PelionIoT/reference-design-RD1622/README.md

# RD1622 Introduction:

The RD1622 Reference Design is a Pelion Ready design based on the hostless Advantech WISE-1530 Wi-Fi module which includes an ST Microcontroller (STM32F412) and a Cypress Wi-Fi device (CYW43438).

The reference design is a tested and proven starting point targetted towards the creation of both Development Boards and End Products.

# Reference Design Contents:
**Reference Schematic**
This is the core of reference design, and illustrates where and how the essential components are connected.

**Reference Application**
Built on mbedOS, and includes Pelion Device Manager. This application has been configured to run on the Reference Design hardware, and will connect to the Pelion Cloud, and is capable of running the cloud based update service.

**Example Implementation**
Based on the Reference Design, this example implementation is included to demonstrate the Reference Design being used to create real-world hardware. The example implemenation is used within Arm to include the Reference Design into the internal test infrastructure, it is comprised of two parts:

*MCB (Module Carrier Board)* - this was created based on the Reference Design schematic

*MTB (Module Test Bed)* - this is part of the test infrastructure, and includes DAPLink circuit for programming the device, a range of I/O and loopback paths for automated testing.

# Version Information:

| Release | mbed OS | mbed Cloud Client | Release Date | Comment |
| --- | --- | --- | --- | --- |
|v1.0 | 5.9.5	| 1.3.3	| 20/09/2018 | Initial Release
| |  |  | |

Back to [Reference Designs](https://github.com/ARMmbed/reference-designs)
