PelionIoT/reference-design-RD1622/Hardware/Example_Implementation/Module_Carrier_Board/MCB-Wise-1530-v2.0.1-BOM.xlsx

Qty | Value | Device | Package | Parts | Description | MF | MFN | OC-DIGIKEY | OC-MOUSER | OC-NEWARK
5 | 100nF | C0603 | 0603 | C1, C2, C3, C6, C7 | Capacitor |  |  | 732-7989-1-ND | 710-885012206071 | 2392304
3 | 10k | R0603 | 0603 | R1, R2, R3 | Resistor |  |  | 311-10KGRCT-ND | 603-RC0603JR-0710KL | 2447230
1 | 1k | R0603 | 0603 | R8 | Resistor |  |  | 311-1.0KGRCT-ND | 603-RC0603JR-071KL | 2447272
1 | 3030 | 3030 | 3030 | BAT1 | CR927, CR1025 Battery Holder for 9-10mm Cells-Tin Nickel Plated SMD | Keystone | 3030 | 36-3030-ND | 534-3030 | 39T8899
1 | ATECC608A | ATECC608A | SO8 | IC1 | I2C Secure element and crytpo accelerator | Atmel | ATECC608A | ATECC608A-SSHDA-TCT-ND | 556-ATECC608ASSHDAB
1 | MX25R3235FM1IH0 | MX25R3235FM1IH0 | SO8 | IC2 | Serial Flash 32 Mb 80 Mhz | Macronix | MX25R3235FM1IH0 | 1092-1175-ND
1 | RED | SMD_LED0603 | CHIPLED_0603 | LED1 | LED SMD, Colour Red | Wurth Electronics Inc | 150060RS75000 | 732-4978-1-ND | 710-150060RS75000 | 2322071
1 | TE-1-1734592-0 | TE-1-1734592-0 | TE-1-1734592-0 | CON3 | 10 way FPC cable connector | TE Connectivity | TE-1-1734592-0 | A100282CT-ND | 571-1-1734592-0
1 | WISE-1530 | WISE-1530 | MDT420E02001 | MOD1 | Connector for Advantex WISE-1530 module | Amphenol | MDT420E02001 | na | 523-MDT420E02001 | na
