PelionIoT/reference-design-RD1622/Hardware/Reference_Schematic/Advantech-Wise-1530-v1.0.0-SCH.pdf

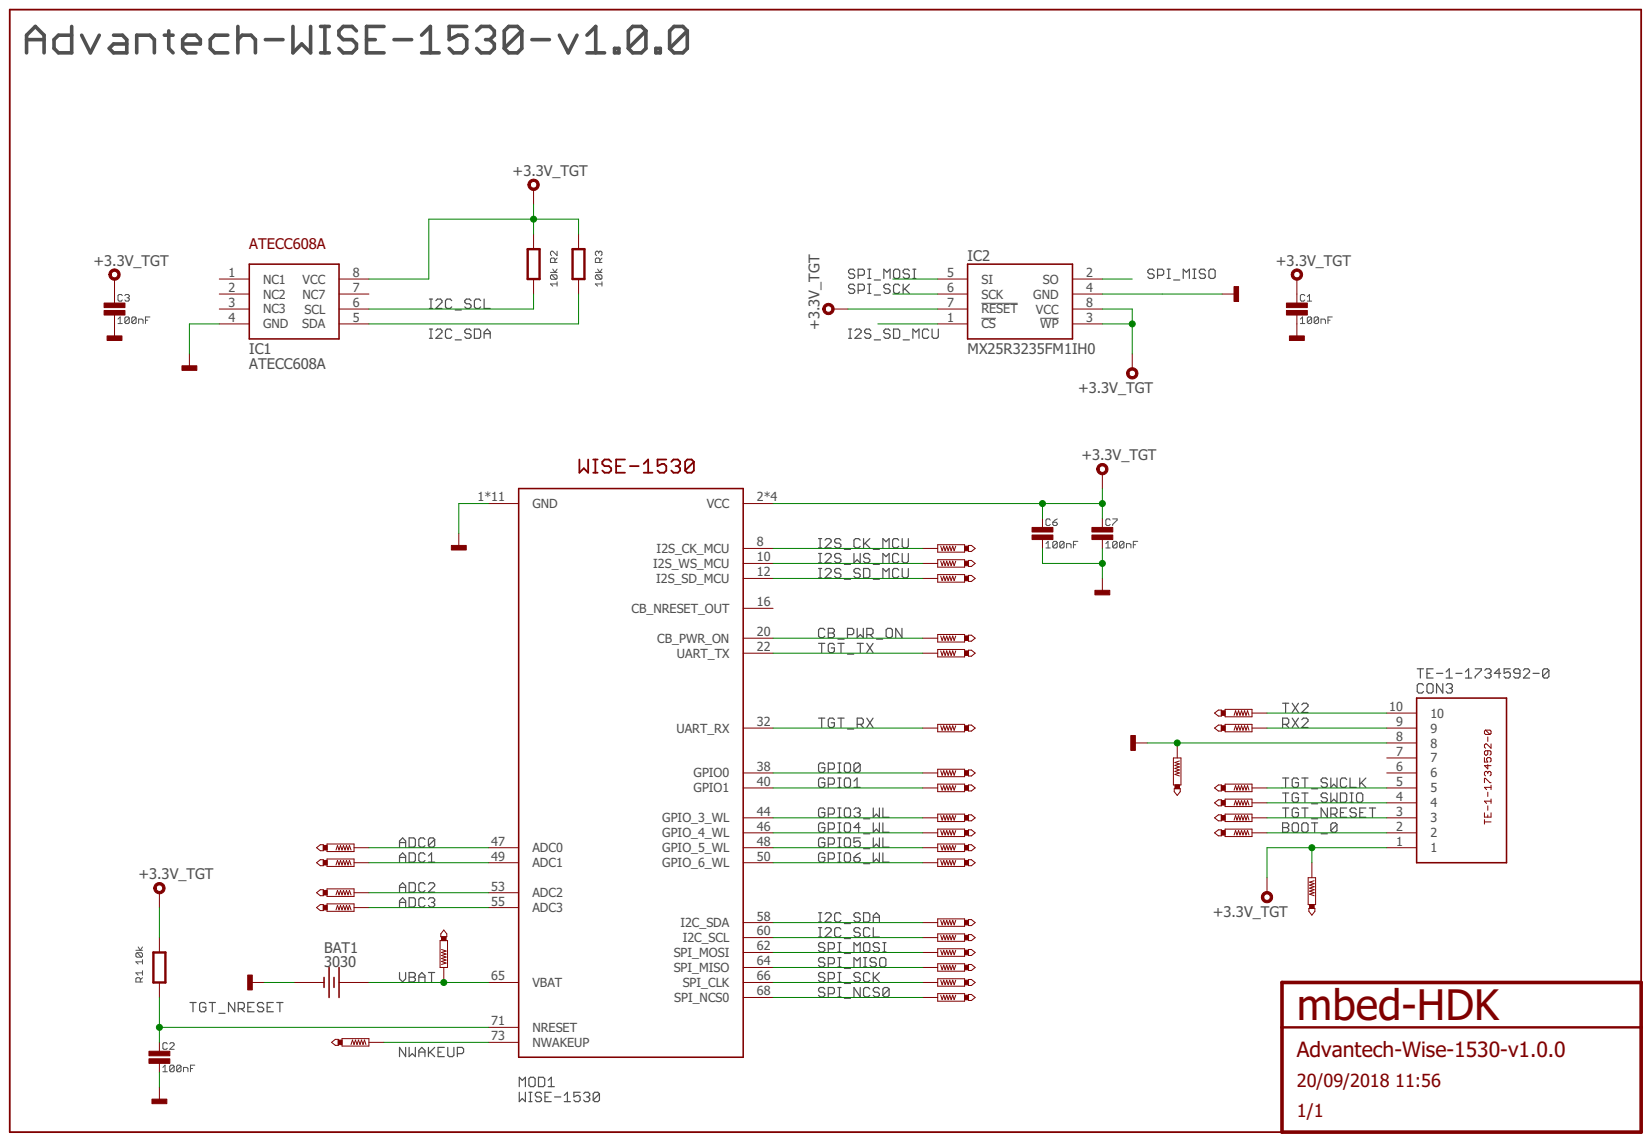
[picture p1: page 1]
