PelionIoT/reference-design-RD1622/Hardware/Example_Implementation/Module_Test_Bed/MTB-v2.0.0.brd

## EAGLE design Hardware/Example_Implementation/Module_Test_Bed/MTB-v2.0.0.brd (2018-09-20)

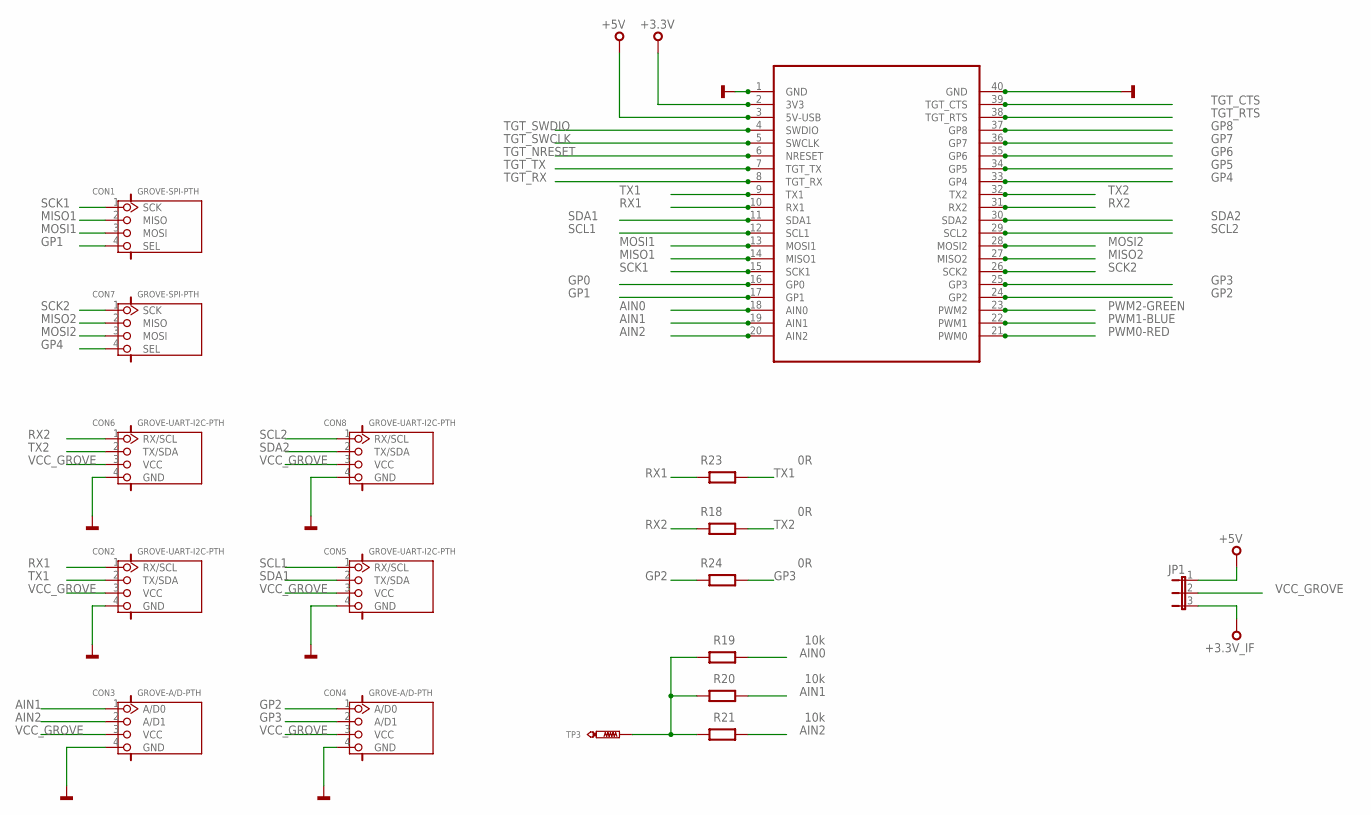
[picture p2: schematic MTB-v2.0.0.sch, sheet 1]

Parts:
CON1, CON7: GROVE-SPI-PTH; HW4-2.0
CON2, CON5, CON6, CON8: GROVE-UART-I2C-PTH; HW4-2.0
CON3, CON4: GROVE-A/D-PTH; HW4-2.0
JP1: JP2E; JP2
R18, R23, R24: 0R; 0603@1
R19, R20, R21: 10k; 0603@1
SKT1: MODULE_SOCKET
TP3: TEST-POINT-50R-PTH; TP50-PTH

Connections:
+3.3V: SKT1.2 (3V3), SKT1.P$42; also elsewhere on the board
+3.3V_IF: JP1.3; also elsewhere on the board
+5V: JP1.1, SKT1.3 (5V-USB), SKT1.P$43; also elsewhere on the board
AIN0: R19.1, SKT1.18 (AIN0), SKT1.P$58; also elsewhere on the board
AIN1: CON3.1 (A/D0), R20.1, SKT1.19 (AIN1), SKT1.P$59
AIN2: CON3.2 (A/D1), R21.1, SKT1.20 (AIN2), SKT1.P$60
GND: CON2.4 (GND), CON3.4 (GND), CON4.4 (GND), CON5.4 (GND), CON6.4 (GND), CON8.4 (GND), SKT1.1 (GND), SKT1.40 (GND), SKT1.P$41, SKT1.P$80; also elsewhere on the board
GP0: SKT1.16 (GP0), SKT1.P$56; also elsewhere on the board
GP1: CON1.4 (SEL), SKT1.17 (GP1), SKT1.P$57
GP2: CON4.1 (A/D0), R24.2, SKT1.24 (GP2), SKT1.P$64; also elsewhere on the board
GP3: CON4.2 (A/D1), R24.1, SKT1.25 (GP3), SKT1.P$65
GP4: CON7.4 (SEL), SKT1.33 (GP4), SKT1.P$73
GP5: SKT1.34 (GP5), SKT1.P$74; also elsewhere on the board
GP6: SKT1.35 (GP6), SKT1.P$75; also elsewhere on the board
GP7: SKT1.36 (GP7), SKT1.P$76; also elsewhere on the board
GP8: SKT1.37 (GP8), SKT1.P$77
MISO1: CON1.2 (MISO), SKT1.14 (MISO1), SKT1.P$54; also elsewhere on the board
MISO2: CON7.2 (MISO), SKT1.27 (MISO2), SKT1.P$67
MOSI1: CON1.3 (MOSI), SKT1.13 (MOSI1), SKT1.P$53; also elsewhere on the board
MOSI2: CON7.3 (MOSI), SKT1.28 (MOSI2), SKT1.P$68
unnamed: R19.2, R20.2, R21.2, TP3.TP
PWM0-RED: SKT1.21 (PWM0), SKT1.P$61; also elsewhere on the board
PWM1-BLUE: SKT1.22 (PWM1), SKT1.P$62; also elsewhere on the board
PWM2-GREEN: SKT1.23 (PWM2), SKT1.P$63; also elsewhere on the board
RX1: CON2.1 (RX/SCL), R23.2, SKT1.10 (RX1), SKT1.P$50
RX2: CON6.1 (RX/SCL), R18.2, SKT1.31 (RX2), SKT1.P$71
SCK1: CON1.1 (SCK), SKT1.15 (SCK1), SKT1.P$55; also elsewhere on the board
SCK2: CON7.1 (SCK), SKT1.26 (SCK2), SKT1.P$66
SCL1: CON5.1 (RX/SCL), SKT1.12 (SCL1), SKT1.P$52; also elsewhere on the board
SCL2: CON8.1 (RX/SCL), SKT1.29 (SCL2), SKT1.P$69; also elsewhere on the board
SDA1: CON5.2 (TX/SDA), SKT1.11 (SDA1), SKT1.P$51; also elsewhere on the board
SDA2: CON8.2 (TX/SDA), SKT1.30 (SDA2), SKT1.P$70; also elsewhere on the board
TGT_CTS: SKT1.39 (TGT_CTS), SKT1.P$79; also elsewhere on the board
TGT_NRESET: SKT1.6 (NRESET), SKT1.P$46; also elsewhere on the board
TGT_RTS: SKT1.38 (TGT_RTS), SKT1.P$78; also elsewhere on the board
TGT_RX: SKT1.8 (TGT_RX), SKT1.P$48; also elsewhere on the board
TGT_SWCLK: SKT1.5 (SWCLK), SKT1.P$45; also elsewhere on the board
TGT_SWDIO: SKT1.4 (SWDIO), SKT1.P$44; also elsewhere on the board
TGT_TX: SKT1.7 (TGT_TX), SKT1.P$47; also elsewhere on the board
TX1: CON2.2 (TX/SDA), R23.1, SKT1.9 (TX1), SKT1.P$49
TX2: CON6.2 (TX/SDA), R18.1, SKT1.32 (TX2), SKT1.P$72
VCC_GROVE: CON2.3 (VCC), CON3.3 (VCC), CON4.3 (VCC), CON5.3 (VCC), CON6.3 (VCC), CON8.3 (VCC), JP1.2

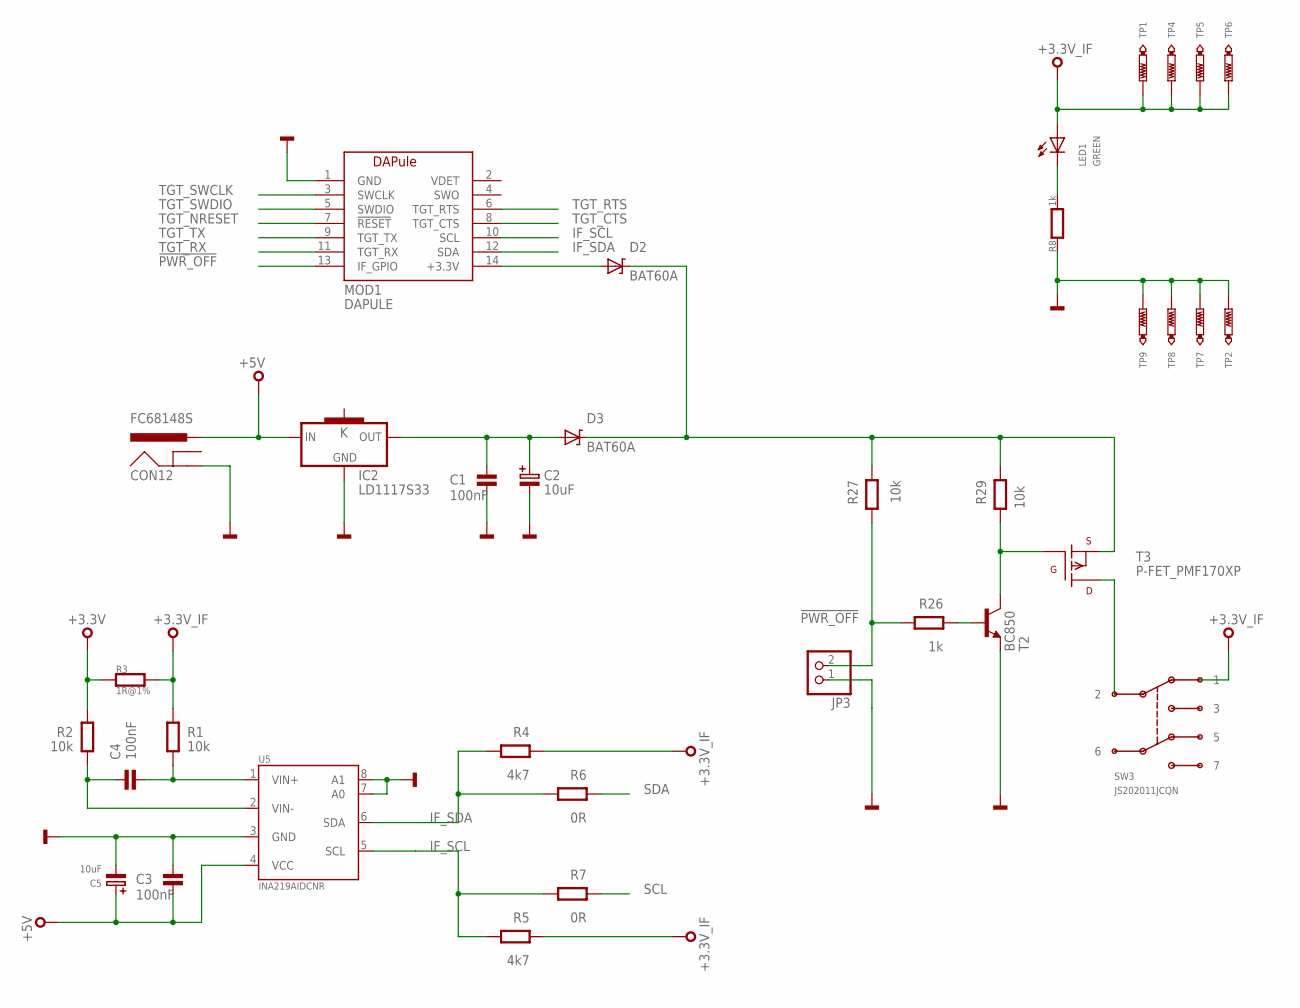
[picture p3: schematic MTB-v2.0.0.sch, sheet 2]

Parts:
C1, C3, C4: 100nF; 0603
C2: 10uF; SMC_B
C5: 10uF; SMC_A
CON12: FC68148S
D2, D3: BAT60A; SOD323
IC2: LD1117S33; SOT223
JP3: PINHD-1X2; 1X02
LED1: GREEN; CHIPLED_0603
MOD1: DAPULE
R1, R2, R27, R29: 10k; 0603@1
R3: 1R@1%; 0603
R4, R5: 4k7; 0603@1
R6, R7: 0R; 0603@1
R8: 1k; 0603
R26: 1k; 0603@1
SW3: JS202011JCQN
T2: BC850; SOT23
T3: P-FET_PMF170XP; SOT23-BEC
TP1, TP2, TP4, TP5, TP6, TP7, TP8, TP9: TEST-POINT-50R-PTH; TP50-PTH
U5: INA219AIDCNR; SOT23-8

Connections:
!PWR_OFF: JP3.2, MOD1.13 (IF_GPIO), R26.2, R27.2
+3.3V: R2.2, R3.1; also elsewhere on the board
+3.3V_IF: LED1.A, R1.2, R3.2, R4.1, R5.1, SW3.1, TP1.TP, TP4.TP, TP5.TP, TP6.TP; also elsewhere on the board
+5V: C3.2, C5.+, CON12.1-1 (PWR), CON12.1-2 (PWR), IC2.3 (IN), U5.4 (VCC); also elsewhere on the board
GND: C1.2, C2.-, C3.1, C5.-, CON12.3 (GND), IC2.1 (GND), JP3.1, MOD1.1 (GND), R8.1, T2.2 (E), TP2.TP, TP7.TP, TP8.TP, TP9.TP, U5.3 (GND), U5.7 (A0), U5.8 (A1); also elsewhere on the board
IF_SCL: MOD1.10 (SCL), R5.2, R7.2, U5.5 (SCL)
IF_SDA: MOD1.12 (SDA), R4.2, R6.2, U5.6 (SDA)
unnamed: C4.2, R2.1, U5.2 (VIN-)
unnamed: C4.1, R1.1, U5.1 (VIN+)
unnamed: D2.A, MOD1.14 (+3.3V)
unnamed: C1.1, C2.+, D3.A, IC2.2 (OUT)
unnamed: D2.K, D3.K, R27.1, R29.1, T3.E (S)
unnamed: R26.1, T2.1 (B)
unnamed: SW3.2, T3.C (D)
unnamed: R29.2, T2.3 (C), T3.B (G)
PA_1: LED1.C, R8.2
SCL: R7.1; also elsewhere on the board
SDA: R6.1; also elsewhere on the board
TGT_CTS: MOD1.8 (TGT_CTS); also elsewhere on the board
TGT_NRESET: MOD1.7 (!RESET); also elsewhere on the board
TGT_RTS: MOD1.6 (TGT_RTS); also elsewhere on the board
TGT_RX: MOD1.11 (TGT_RX); also elsewhere on the board
TGT_SWCLK: MOD1.3 (SWCLK); also elsewhere on the board
TGT_SWDIO: MOD1.5 (SWDIO); also elsewhere on the board
TGT_TX: MOD1.9 (TGT_TX); also elsewhere on the board

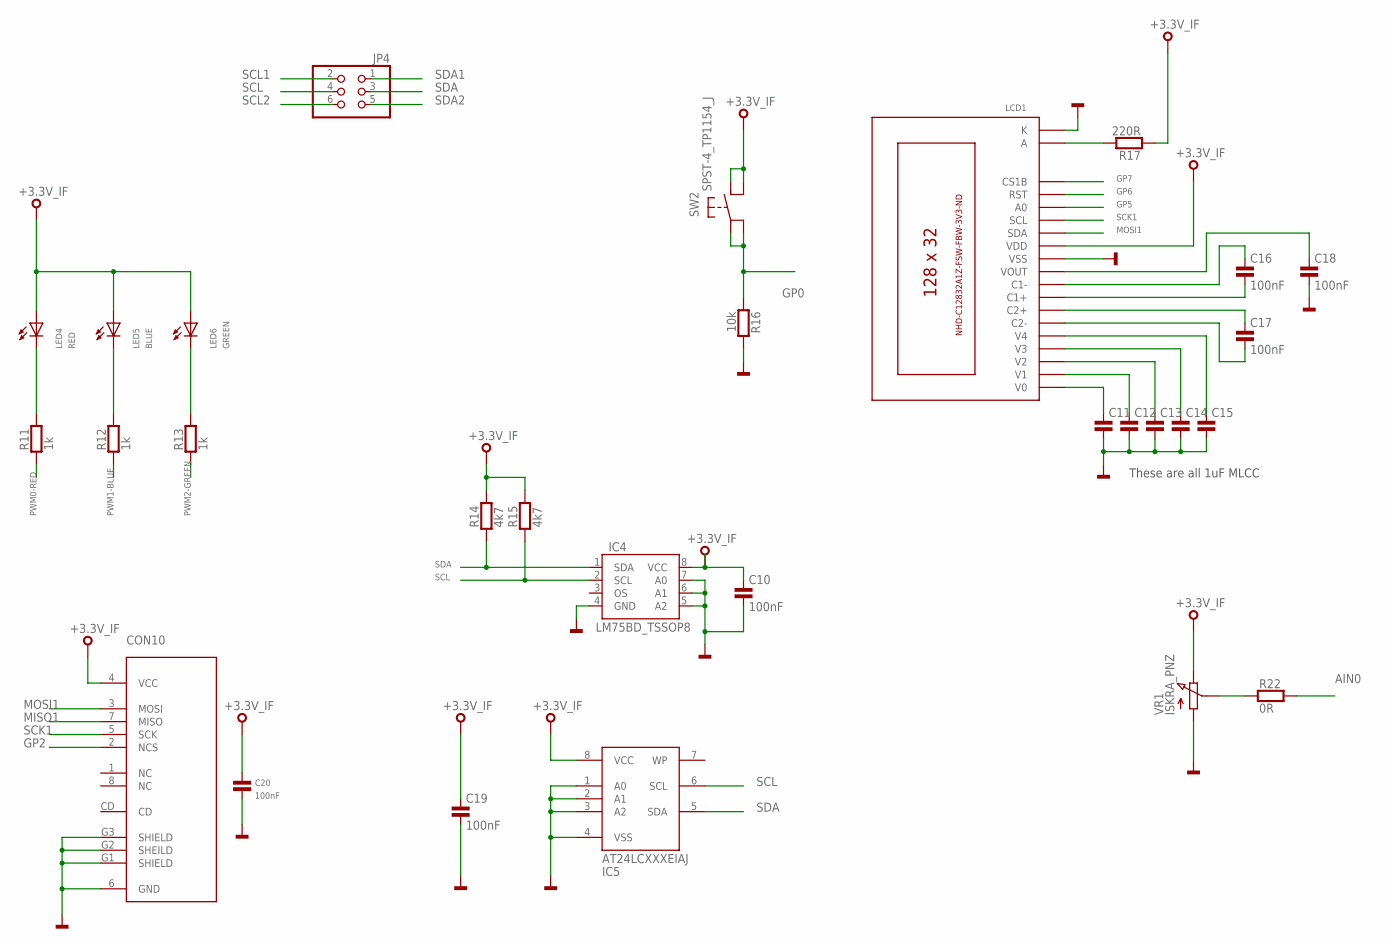
[picture p4: schematic MTB-v2.0.0.sch, sheet 3]

Parts:
C10, C11, C12, C13, C14, C15, C16, C17, C18, C19, C20: 100nF; 0603
CON10: MICRO-SD; AMPHENOL-101-00660-68-6
IC4: LM75BD_TSSOP8; TSSOP8
IC5: AT24LCXXXEIAJ; SO08-EIAJ
JP4: PINHD-2X3; 2X03
LCD1: C12832A1Z
LED4: RED; CHIPLED_0603
LED5: BLUE; CHIPLED_0603
LED6: GREEN; CHIPLED_0603
R11, R12, R13: 1k; 0603
R14, R15: 4k7; 0603
R16: 10k; 0603
R17: 220R; 0603
R22: 0R; 0603
SW2: SPST-4_TP1154_J; TP-1154X
VR1: ISKRA_PNZ; CA14V

Connections:
+3.3V_IF: C10.1, C19.1, C20.1, CON10.4 (VCC), IC4.8 (VCC), IC5.8 (VCC), LCD1.P$12 (VDD), LED4.A, LED5.A, LED6.A, R14.2, R15.2, R17.1, SW2.B1, SW2.B2, VR1.P$3 (E); also elsewhere on the board
AIN0: R22.2; also elsewhere on the board
GND: C10.2, C11.2, C12.2, C13.2, C14.2, C15.2, C18.2, C19.2, C20.2, CON10.6 (GND), CON10.G1 (SHIELD), CON10.G2 (SHEILD), CON10.G3 (SHIELD), IC4.4 (GND), IC4.5 (A2), IC4.6 (A1), IC4.7 (A0), IC5.1 (A0), IC5.2 (A1), IC5.3 (A2), IC5.4 (VSS), LCD1.K, LCD1.P$11 (VSS), R16.2, VR1.P$1 (A); also elsewhere on the board
GP0: R16.1, SW2.A1, SW2.A2; also elsewhere on the board
GP2: CON10.2 (NCS); also elsewhere on the board
GP5: LCD1.P$15 (A0); also elsewhere on the board
GP6: LCD1.P$16 (RST); also elsewhere on the board
GP7: LCD1.P$17 (CS1B); also elsewhere on the board
MISO1: CON10.7 (MISO); also elsewhere on the board
MOSI1: CON10.3 (MOSI), LCD1.P$13 (SDA); also elsewhere on the board
unnamed: C16.1, LCD1.P$9 (C1-)
unnamed: C17.1, LCD1.P$7 (C2+)
unnamed: C17.2, LCD1.P$6 (C2-)
unnamed: C16.2, LCD1.P$8 (C1+)
unnamed: C11.1, LCD1.P$1 (V0)
unnamed: C12.1, LCD1.P$2 (V1)
unnamed: C13.1, LCD1.P$3 (V2)
unnamed: C14.1, LCD1.P$4 (V3)
unnamed: C15.1, LCD1.P$5 (V4)
unnamed: C18.1, LCD1.P$10 (VOUT)
unnamed: LED4.C, R11.2
unnamed: LED6.C, R13.2
unnamed: LED5.C, R12.2
unnamed: LCD1.A, R17.2
unnamed: R22.1, VR1.P$2 (S)
PWM0-RED: R11.1; also elsewhere on the board
PWM1-BLUE: R12.1; also elsewhere on the board
PWM2-GREEN: R13.1; also elsewhere on the board
SCK1: CON10.5 (SCK), LCD1.P$14 (SCL); also elsewhere on the board
SCL: IC4.2 (SCL), IC5.6 (SCL), JP4.4, R15.1; also elsewhere on the board
SCL1: JP4.2; also elsewhere on the board
SCL2: JP4.6; also elsewhere on the board
SDA: IC4.1 (SDA), IC5.5 (SDA), JP4.3, R14.1; also elsewhere on the board
SDA1: JP4.1; also elsewhere on the board
SDA2: JP4.5; also elsewhere on the board

Notes on the sheet:
These are all 1uF MLCC

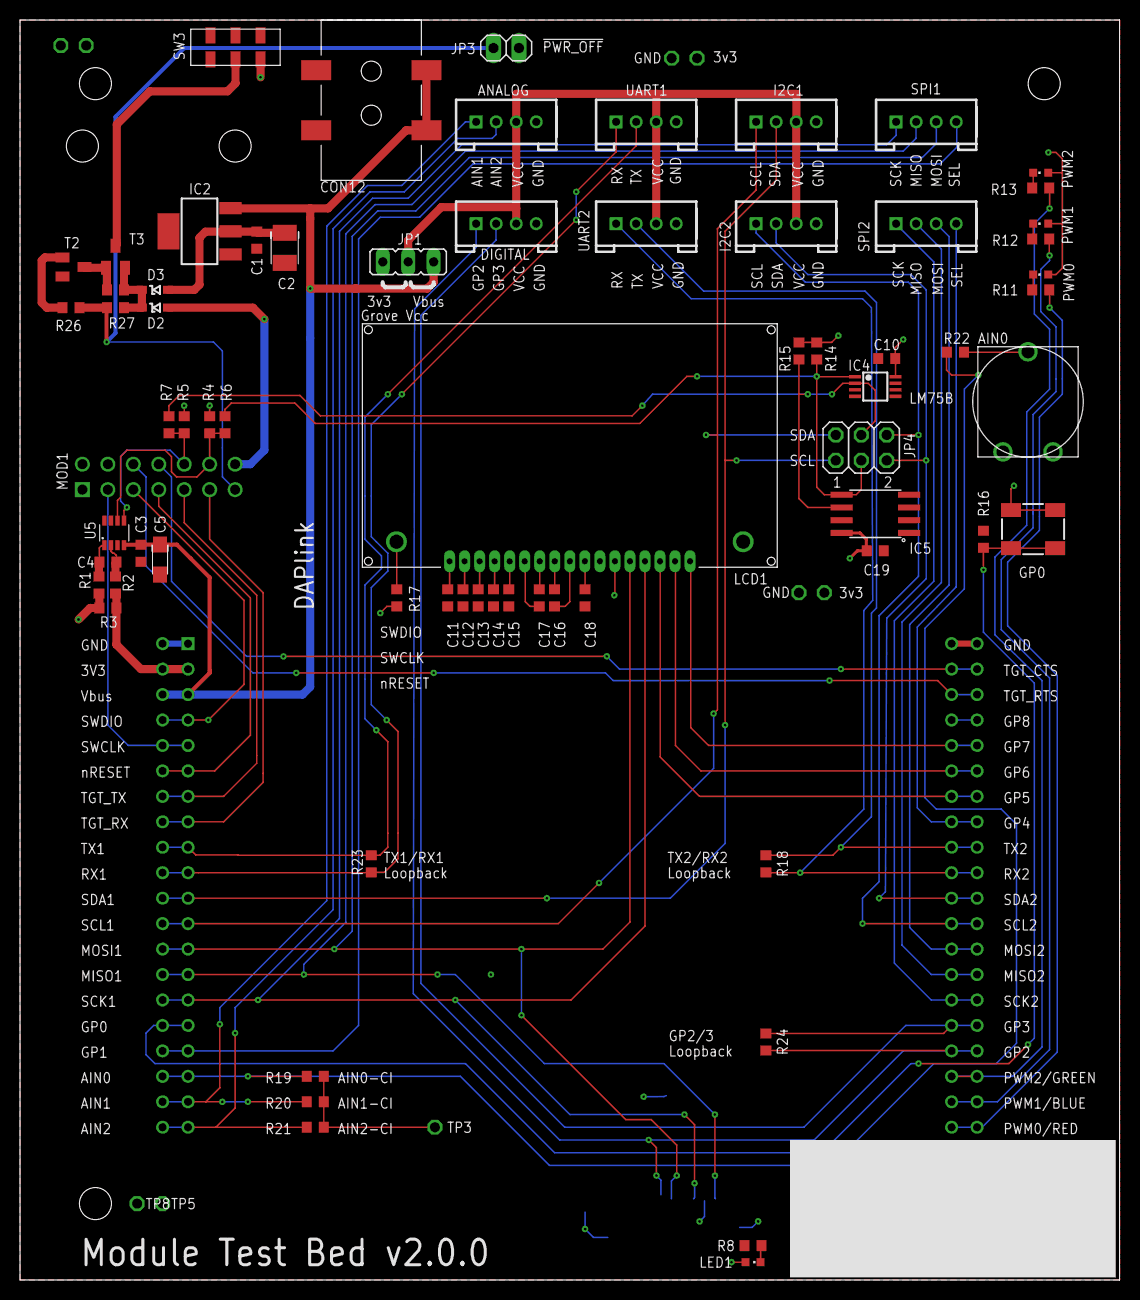
[picture p5: board MTB-v2.0.0.brd from above]

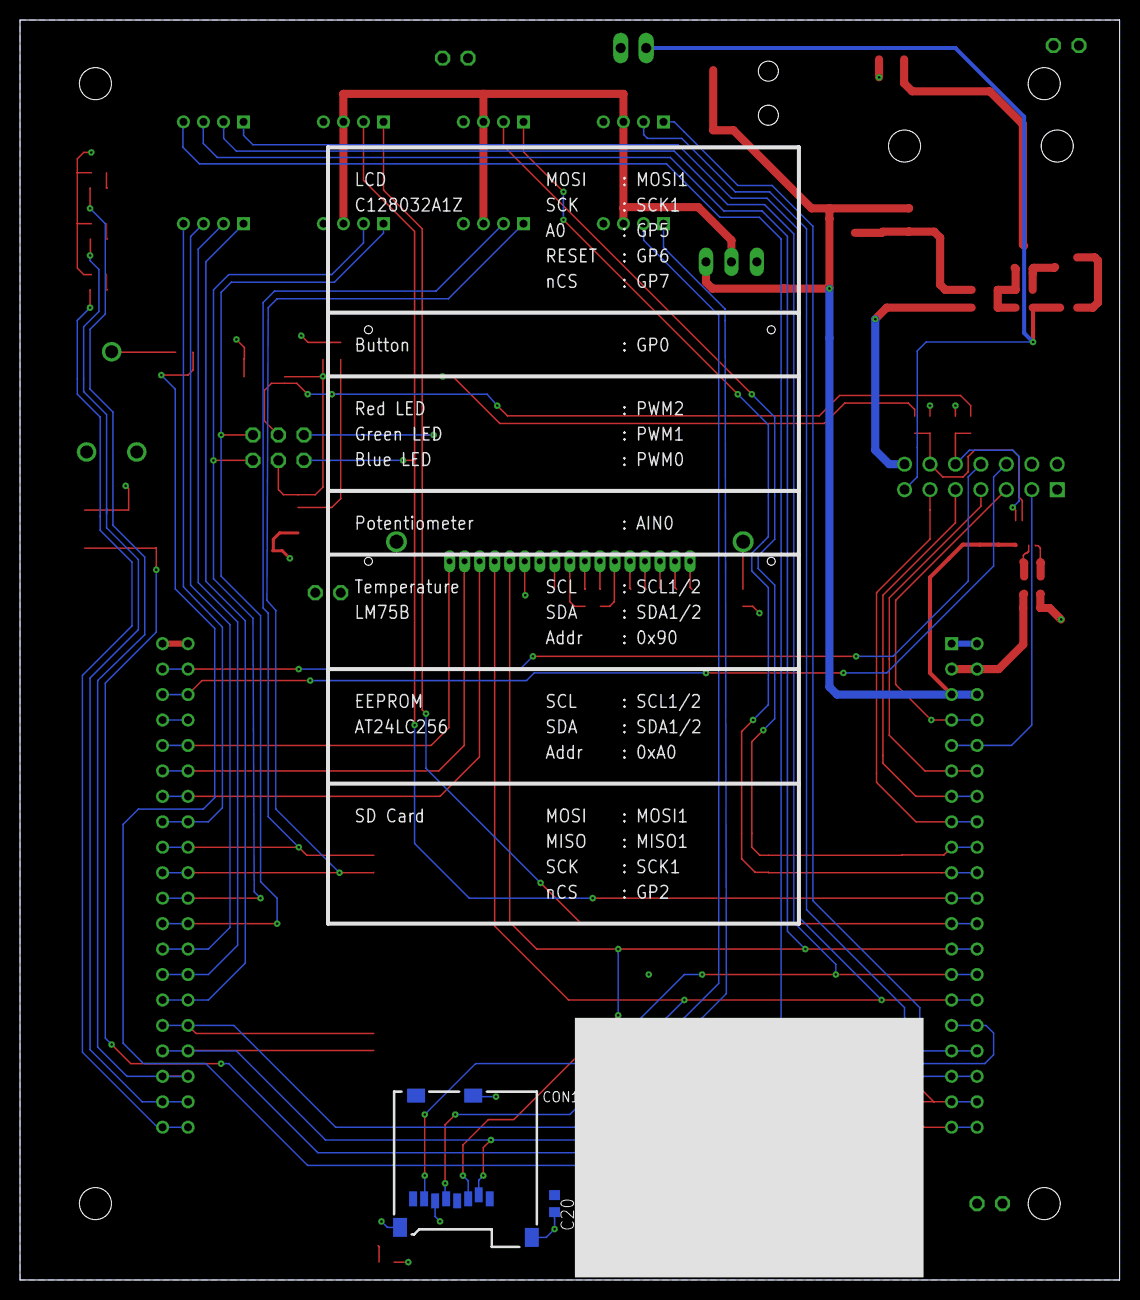
[picture p6: board MTB-v2.0.0.brd from below]

Board: 2 copper layers, 109.7 x 125.7 mm, 81 parts (2 on the bottom side), 71 nets.
