PelionIoT/reference-design-RD1622/Hardware/Example_Implementation/Module_Carrier_Board/MCB-Wise-1530-v2.0.1.brd

## EAGLE design Hardware/Example_Implementation/Module_Carrier_Board/MCB-Wise-1530-v2.0.1.brd (2018-09-20)

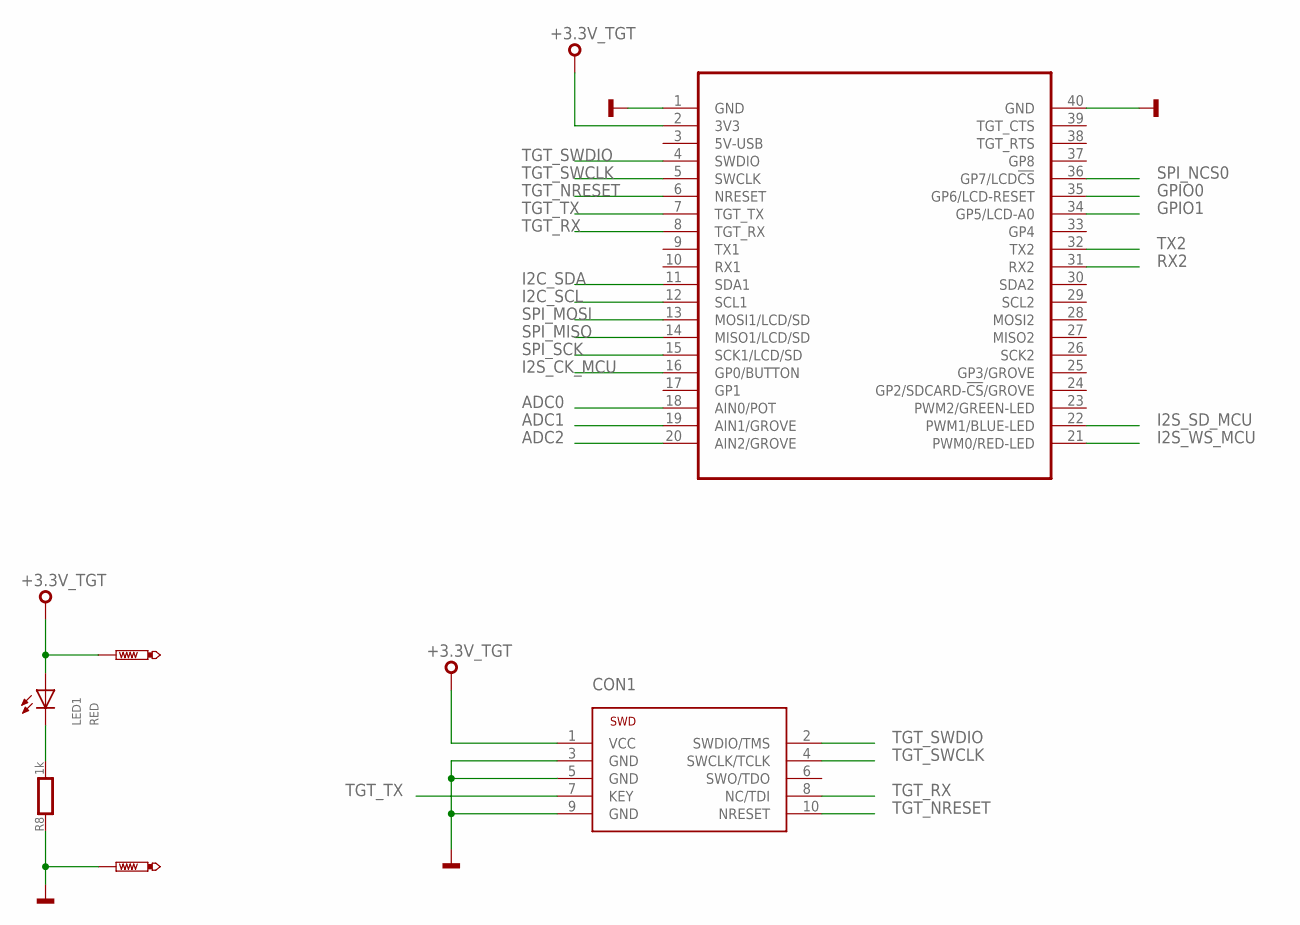
[picture p7: schematic MCB-Wise-1530-v2.0.1.sch, sheet 1]

Parts:
CON1: SWD-10-SMD
LED1: RED; CHIPLED_0603
MOD2: MODULE_DAUGHTER
R8: 1k; 0603
TP1, TP2: PTR1P1-10; P1-10

Connections:
+3.3V_TGT: CON1.1 (VCC), LED1.A, MOD2.2 (3V3), TP1.TP; also elsewhere on the board
ADC0: MOD2.18 (AIN0/POT); also elsewhere on the board
ADC1: MOD2.19 (AIN1/GROVE); also elsewhere on the board
ADC2: MOD2.20 (AIN2/GROVE); also elsewhere on the board
GND: CON1.3 (GND), CON1.5 (GND), CON1.9 (GND), MOD2.1 (GND), MOD2.40 (GND), R8.1, TP2.TP; also elsewhere on the board
GPIO0: MOD2.35 (GP6/LCD-RESET); also elsewhere on the board
GPIO1: MOD2.34 (GP5/LCD-A0); also elsewhere on the board
I2C_SCL: MOD2.12 (SCL1); also elsewhere on the board
I2C_SDA: MOD2.11 (SDA1); also elsewhere on the board
I2S_CK_MCU: MOD2.16 (GP0/BUTTON); also elsewhere on the board
I2S_SD_MCU: MOD2.22 (PWM1/BLUE-LED); also elsewhere on the board
I2S_WS_MCU: MOD2.21 (PWM0/RED-LED); also elsewhere on the board
PA_1: LED1.C, R8.2
RX2: MOD2.31 (RX2); also elsewhere on the board
SPI_MISO: MOD2.14 (MISO1/LCD/SD); also elsewhere on the board
SPI_MOSI: MOD2.13 (MOSI1/LCD/SD); also elsewhere on the board
SPI_NCS0: MOD2.36 (GP7/LCD!CS); also elsewhere on the board
SPI_SCK: MOD2.15 (SCK1/LCD/SD); also elsewhere on the board
TGT_NRESET: CON1.10 (NRESET), MOD2.6 (NRESET); also elsewhere on the board
TGT_RX: CON1.8 (NC/TDI), MOD2.8 (TGT_RX); also elsewhere on the board
TGT_SWCLK: CON1.4 (SWCLK/TCLK), MOD2.5 (SWCLK); also elsewhere on the board
TGT_SWDIO: CON1.2 (SWDIO/TMS), MOD2.4 (SWDIO); also elsewhere on the board
TGT_TX: CON1.7 (KEY), MOD2.7 (TGT_TX); also elsewhere on the board
TX2: MOD2.32 (TX2); also elsewhere on the board

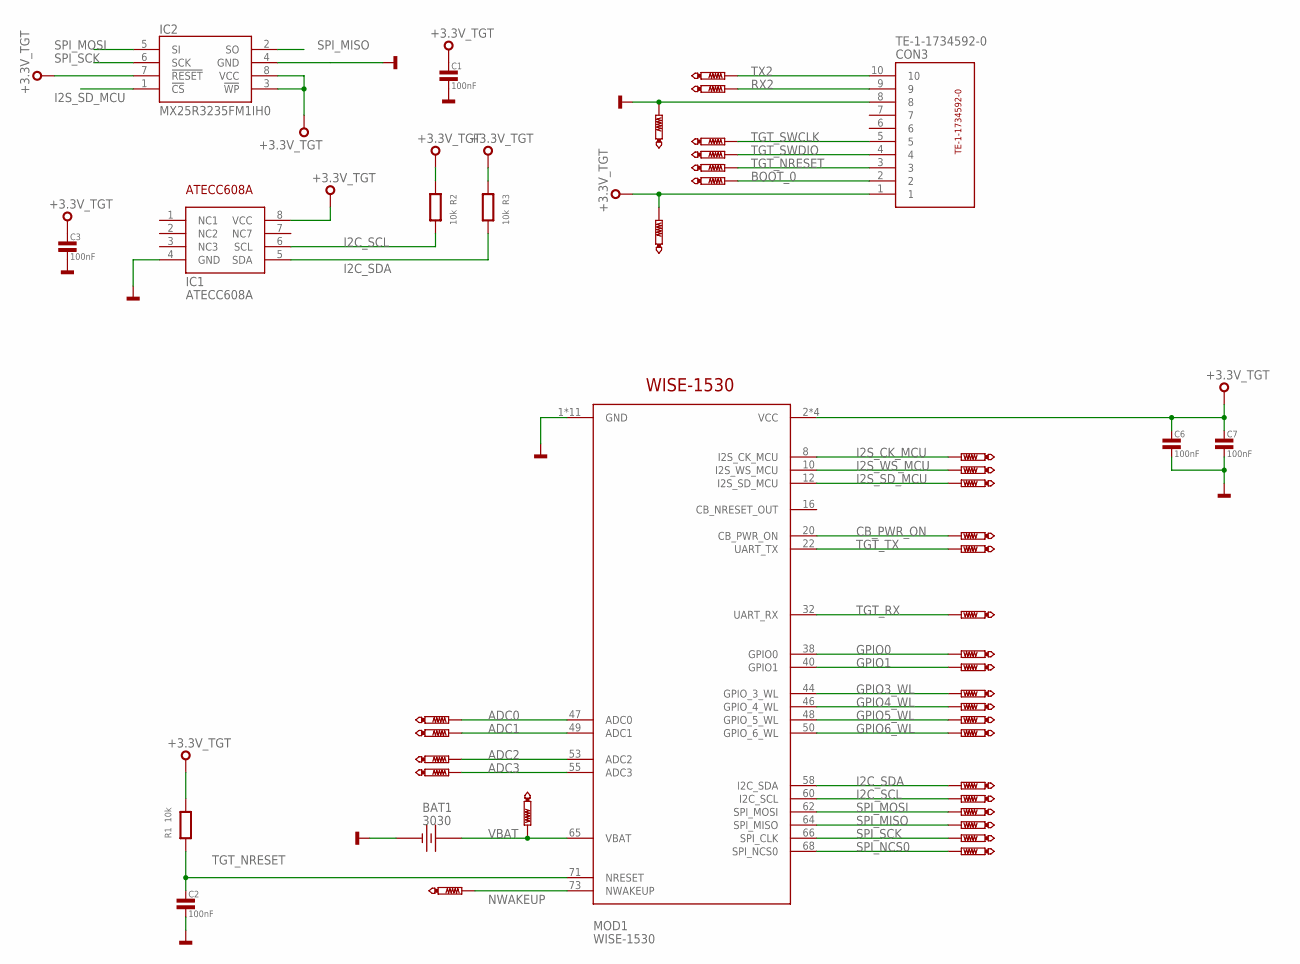
[picture p8: schematic MCB-Wise-1530-v2.0.1.sch, sheet 2]

Parts:
BAT1: 3030
C1, C2, C3, C6, C7: 100nF; 0603
CON3: TE-1-1734592-0
IC1: ATECC608A; SO8
IC2: MX25R3235FM1IH0; SO8
MOD1: WISE-1530; MDT420E02001
R1, R2, R3: 10k; 0603
TP3, TP4, TP5, TP6, TP7, TP8, TP9, TP10, TP11, TP12, TP13, TP14, TP15, TP16, TP17, TP18, TP19, TP20, TP21, TP22, TP23, TP24, TP25, TP26, TP27, TP28, TP29, TP30, TP31, TP32, TP33, TP34: PTR1TP08R; TP08R

Connections:
+3.3V_TGT: C1.1, C3.1, C6.1, C7.1, CON3.1, IC1.8 (VCC), IC2.3 (!WP), IC2.7 (!RESET), IC2.8 (VCC), MOD1.2 (VCC), MOD1.4 (VCC), MOD1.72 (VCC), MOD1.74 (VCC), R1.2, R2.1, R3.1, TP12.TP; also elsewhere on the board
ADC0: MOD1.47 (ADC0), TP29.TP; also elsewhere on the board
ADC1: MOD1.49 (ADC1), TP30.TP; also elsewhere on the board
ADC2: MOD1.53 (ADC2), TP31.TP; also elsewhere on the board
ADC3: MOD1.55 (ADC3), TP32.TP
BOOT_0: CON3.2, TP8.TP
CB_PWR_ON: MOD1.20 (CB_PWR_ON), TP14.TP
GND: BAT1.NEG (-), C1.2, C2.2, C3.2, C6.2, C7.2, CON3.8, IC1.4 (GND), IC2.4 (GND), MOD1.1 (GND), MOD1.7 (GND), MOD1.18 (GND), MOD1.33 (GND), MOD1.39 (GND), MOD1.45 (GND), MOD1.51 (GND), MOD1.57 (GND), MOD1.63 (GND), MOD1.69 (GND), MOD1.75 (GND), TP13.TP; also elsewhere on the board
GPIO0: MOD1.38 (GPIO0), TP27.TP; also elsewhere on the board
GPIO1: MOD1.40 (GPIO1), TP26.TP; also elsewhere on the board
GPIO3_WL: MOD1.44 (GPIO_3_WL), TP25.TP
GPIO4_WL: MOD1.46 (GPIO_4_WL), TP24.TP
GPIO5_WL: MOD1.48 (GPIO_5_WL), TP23.TP
GPIO6_WL: MOD1.50 (GPIO_6_WL), TP22.TP
I2C_SCL: IC1.6 (SCL), MOD1.60 (I2C_SCL), R2.2, TP20.TP; also elsewhere on the board
I2C_SDA: IC1.5 (SDA), MOD1.58 (I2C_SDA), R3.2, TP21.TP; also elsewhere on the board
I2S_CK_MCU: MOD1.8 (I2S_CK_MCU), TP9.TP; also elsewhere on the board
I2S_SD_MCU: IC2.1 (!CS), MOD1.12 (I2S_SD_MCU), TP11.TP; also elsewhere on the board
I2S_WS_MCU: MOD1.10 (I2S_WS_MCU), TP10.TP; also elsewhere on the board
NWAKEUP: MOD1.73 (NWAKEUP), TP34.TP
RX2: CON3.9, TP6.TP; also elsewhere on the board
SPI_MISO: IC2.2 (SO), MOD1.64 (SPI_MISO), TP18.TP; also elsewhere on the board
SPI_MOSI: IC2.5 (SI), MOD1.62 (SPI_MOSI), TP19.TP; also elsewhere on the board
SPI_NCS0: MOD1.68 (SPI_NCS0), TP16.TP; also elsewhere on the board
SPI_SCK: IC2.6 (SCK), MOD1.66 (SPI_CLK), TP17.TP; also elsewhere on the board
TGT_NRESET: C2.1, CON3.3, MOD1.71 (NRESET), R1.1, TP5.TP; also elsewhere on the board
TGT_RX: MOD1.32 (UART_RX), TP28.TP; also elsewhere on the board
TGT_SWCLK: CON3.5, TP3.TP; also elsewhere on the board
TGT_SWDIO: CON3.4, TP4.TP; also elsewhere on the board
TGT_TX: MOD1.22 (UART_TX), TP15.TP; also elsewhere on the board
TX2: CON3.10, TP7.TP; also elsewhere on the board
VBAT: BAT1.P$1 (+), BAT1.P$2 (+), MOD1.65 (VBAT), TP33.TP

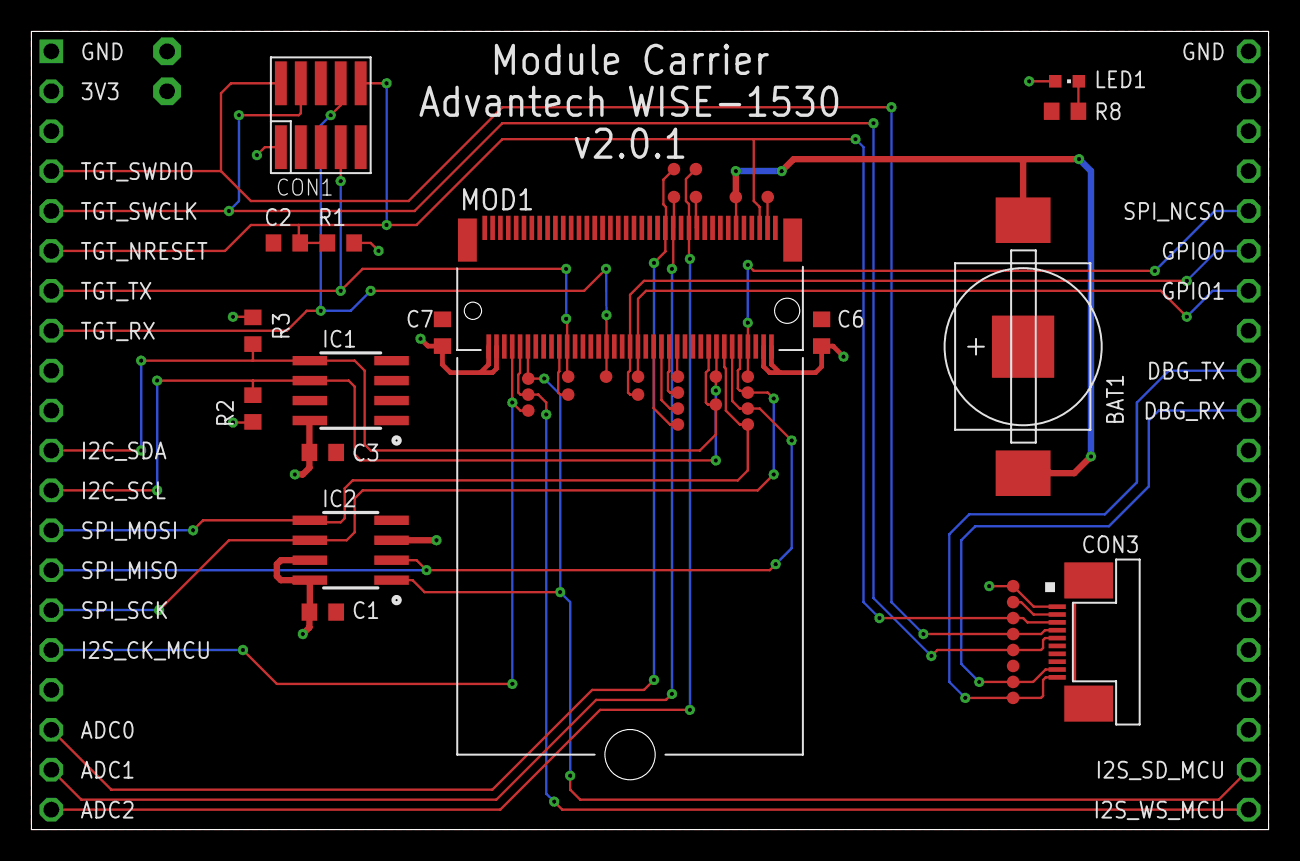
[picture p9: board MCB-Wise-1530-v2.0.1.brd from above]

Board: 2 copper layers, 78.7 x 50.8 mm, 51 parts (0 on the bottom side), 33 nets.
