PelionIoT/reference-design-RD1622/Hardware/Reference_Schematic/Advantech-Wise-1530-v1.0.0.sch

## EAGLE design Hardware/Reference_Schematic/Advantech-Wise-1530-v1.0.0.sch (2018-09-20)

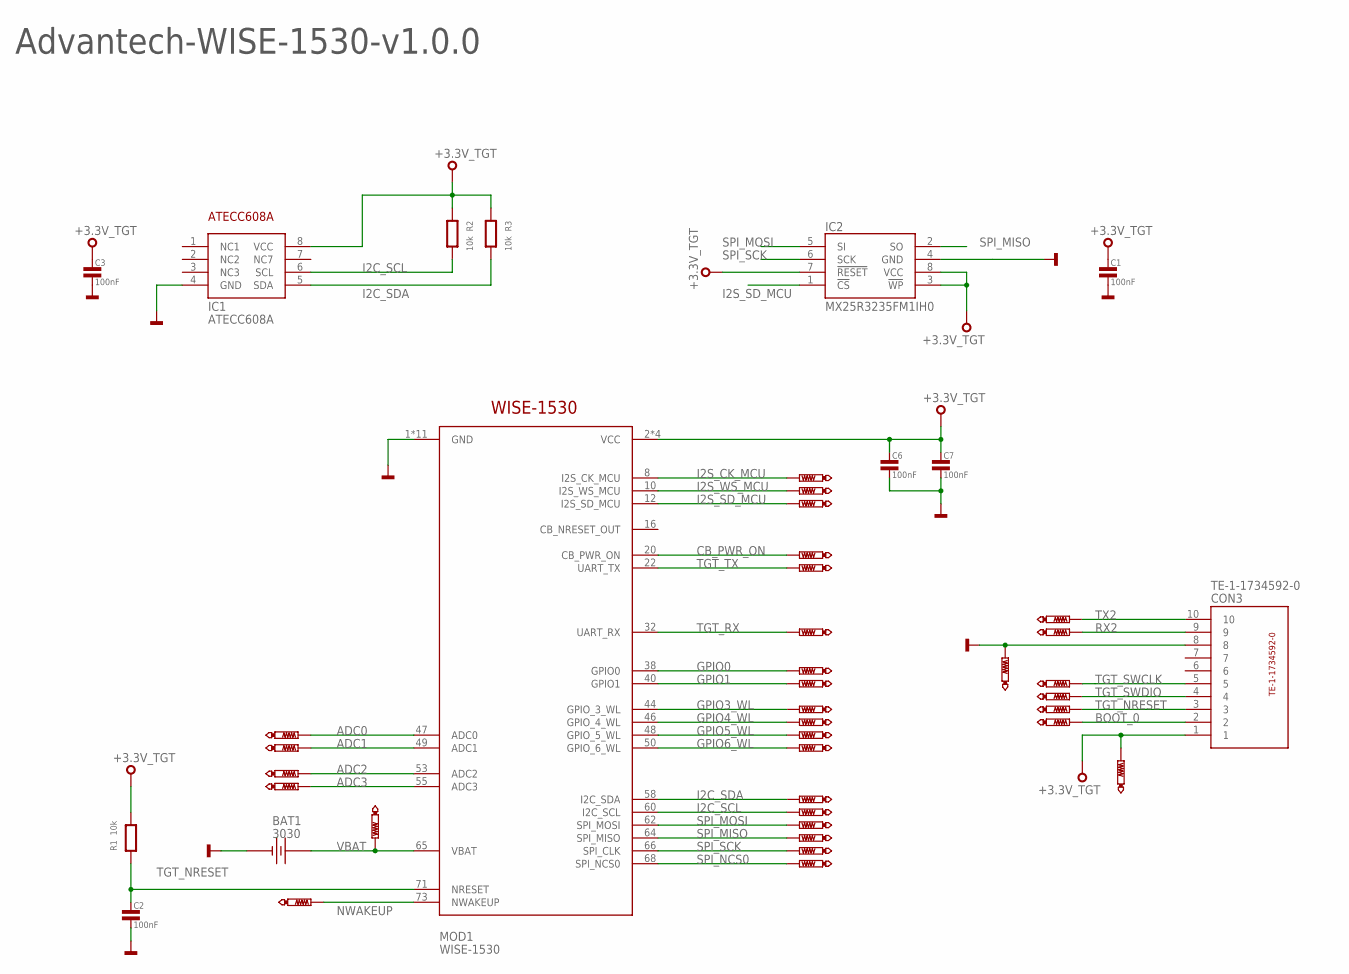
[picture p11: schematic Advantech-Wise-1530-v1.0.0.sch]

Parts:
BAT1: 3030
C1, C2, C3, C6, C7: 100nF; 0603
CON3: TE-1-1734592-0
IC1: ATECC608A; SO8
IC2: MX25R3235FM1IH0; SO8
MOD1: WISE-1530; MDT420E02001
R1, R2, R3: 10k; 0603
TP3, TP4, TP5, TP6, TP7, TP8, TP9, TP10, TP11, TP12, TP13, TP14, TP15, TP16, TP17, TP18, TP19, TP20, TP21, TP22, TP23, TP24, TP25, TP26, TP27, TP28, TP29, TP30, TP31, TP32, TP33, TP34: PTR1TP08R; TP08R

Connections:
+3.3V_TGT: C1.1, C3.1, C6.1, C7.1, CON3.1, IC1.8 (VCC), IC2.3 (!WP), IC2.7 (!RESET), IC2.8 (VCC), MOD1.2 (VCC), R1.2, R2.1, R3.1, TP12.TP
ADC0: MOD1.47 (ADC0), TP29.TP
ADC1: MOD1.49 (ADC1), TP30.TP
ADC2: MOD1.53 (ADC2), TP31.TP
ADC3: MOD1.55 (ADC3), TP32.TP
BOOT_0: CON3.2, TP8.TP
CB_PWR_ON: MOD1.20 (CB_PWR_ON), TP14.TP
GND: BAT1.NEG (-), C1.2, C2.2, C3.2, C6.2, C7.2, CON3.8, IC1.4 (GND), IC2.4 (GND), MOD1.1 (GND), TP13.TP
GPIO0: MOD1.38 (GPIO0), TP27.TP
GPIO1: MOD1.40 (GPIO1), TP26.TP
GPIO3_WL: MOD1.44 (GPIO_3_WL), TP25.TP
GPIO4_WL: MOD1.46 (GPIO_4_WL), TP24.TP
GPIO5_WL: MOD1.48 (GPIO_5_WL), TP23.TP
GPIO6_WL: MOD1.50 (GPIO_6_WL), TP22.TP
I2C_SCL: IC1.6 (SCL), MOD1.60 (I2C_SCL), R2.2, TP20.TP
I2C_SDA: IC1.5 (SDA), MOD1.58 (I2C_SDA), R3.2, TP21.TP
I2S_CK_MCU: MOD1.8 (I2S_CK_MCU), TP9.TP
I2S_SD_MCU: IC2.1 (!CS), MOD1.12 (I2S_SD_MCU), TP11.TP
I2S_WS_MCU: MOD1.10 (I2S_WS_MCU), TP10.TP
NWAKEUP: MOD1.73 (NWAKEUP), TP34.TP
RX2: CON3.9, TP6.TP
SPI_MISO: IC2.2 (SO), MOD1.64 (SPI_MISO), TP18.TP
SPI_MOSI: IC2.5 (SI), MOD1.62 (SPI_MOSI), TP19.TP
SPI_NCS0: MOD1.68 (SPI_NCS0), TP16.TP
SPI_SCK: IC2.6 (SCK), MOD1.66 (SPI_CLK), TP17.TP
TGT_NRESET: C2.1, CON3.3, MOD1.71 (NRESET), R1.1, TP5.TP
TGT_RX: MOD1.32 (UART_RX), TP28.TP
TGT_SWCLK: CON3.5, TP3.TP
TGT_SWDIO: CON3.4, TP4.TP
TGT_TX: MOD1.22 (UART_TX), TP15.TP
TX2: CON3.10, TP7.TP
VBAT: BAT1.P$1 (+), MOD1.65 (VBAT), TP33.TP

Notes on the sheet:
Advantech-WISE-1530-v1.0.0
