PelionIoT/reference-design-RD1622/update_default_resources.c

//----------------------------------------------------------------------------
//   The confidential and proprietary information contained in this file may
//   only be used by a person authorised under and to the extent permitted
//   by a subsisting licensing agreement from ARM Limited or its affiliates.
//
//          (C) COPYRIGHT 2013-2017 ARM Limited or its affiliates.
//              ALL RIGHTS RESERVED
//
//   This entire notice must be reproduced on all copies of this file
//   and copies of this file may only be made by a person if such person is
//   permitted to do so under the terms of a subsisting license agreement
//   from ARM Limited or its affiliates.
//----------------------------------------------------------------------------

#ifdef MBED_CLOUD_CLIENT_USER_CONFIG_FILE
#include MBED_CLOUD_CLIENT_USER_CONFIG_FILE
#endif

#include <stdint.h>

#ifdef MBED_CLOUD_DEV_UPDATE_ID
const uint8_t arm_uc_vendor_id[] = {
    0xfa, 0x6b, 0x4a, 0x53, 0xd5, 0xad, 0x5f, 0xdf, 0xbe, 0x9d, 0xe6, 0x63, 0xe4, 0xd4, 0x1f, 0xfe
};
const uint16_t arm_uc_vendor_id_size = sizeof(arm_uc_vendor_id);

const uint8_t arm_uc_class_id[]  = {
    0xd8, 0xfa, 0x62, 0xe5, 0x28, 0xba, 0x5c, 0x3f, 0x91, 0xaa, 0xe7, 0xc4, 0x8f, 0x9d, 0x62, 0x26
};
const uint16_t arm_uc_class_id_size = sizeof(arm_uc_class_id);
#endif

#ifdef MBED_CLOUD_DEV_UPDATE_CERT
const uint8_t arm_uc_default_fingerprint[] =  {
    0xd4, 0x2a, 0x7b, 0xf4, 0xac, 0xaa, 0xc7, 0xfc, 0x42, 0x18, 0xf3, 0xfc, 0xd6, 0x63, 0xdc, 0x59,
    0x15, 0xef, 0x2c, 0xbc, 0xc, 0x4b, 0x60, 0x9c, 0x8b, 0x62, 0x53, 0xd7, 0xcc, 0x45, 0xd1, 0xe6
};
const uint16_t arm_uc_default_fingerprint_size =
    sizeof(arm_uc_default_fingerprint);

const uint8_t arm_uc_default_subject_key_identifier[] =  {
    0xf2, 0xa5, 0x16, 0x89, 0xa6, 0x64, 0xce, 0x2d, 0xb4, 0x3b, 0xc1, 0xdc, 0xa3, 0x5b, 0xb3, 0xb9,
    0x72, 0x51, 0x10, 0xf5
};
const uint16_t arm_uc_default_subject_key_identifier_size =
    sizeof(arm_uc_default_subject_key_identifier);

const uint8_t arm_uc_default_certificate[] = {
    0x30, 0x82, 0x1, 0x99, 0x30, 0x82, 0x1, 0x3f, 0xa0, 0x3, 0x2, 0x1, 0x2, 0x2, 0x14, 0x40,
    0xfc, 0xa6, 0x32, 0x4e, 0x17, 0x79, 0x50, 0xab, 0xc9, 0xbf, 0x29, 0x3b, 0x7c, 0xc0, 0x37, 0x64,
    0x94, 0xd6, 0xe9, 0x30, 0xa, 0x6, 0x8, 0x2a, 0x86, 0x48, 0xce, 0x3d, 0x4, 0x3, 0x2, 0x30,
    0x1f, 0x31, 0xb, 0x30, 0x9, 0x6, 0x3, 0x55, 0x4, 0x6, 0x13, 0x2, 0x55, 0x4b, 0x31, 0x10,
    0x30, 0xe, 0x6, 0x3, 0x55, 0x4, 0x3, 0xc, 0x7, 0x61, 0x72, 0x6d, 0x2e, 0x63, 0x6f, 0x6d,
    0x30, 0x1e, 0x17, 0xd, 0x31, 0x38, 0x30, 0x39, 0x31, 0x39, 0x30, 0x37, 0x33, 0x32, 0x34, 0x32,
    0x5a, 0x17, 0xd, 0x31, 0x38, 0x31, 0x32, 0x31, 0x38, 0x30, 0x37, 0x33, 0x32, 0x34, 0x32, 0x5a,
    0x30, 0x1f, 0x31, 0xb, 0x30, 0x9, 0x6, 0x3, 0x55, 0x4, 0x6, 0x13, 0x2, 0x55, 0x4b, 0x31,
    0x10, 0x30, 0xe, 0x6, 0x3, 0x55, 0x4, 0x3, 0xc, 0x7, 0x61, 0x72, 0x6d, 0x2e, 0x63, 0x6f,
    0x6d, 0x30, 0x59, 0x30, 0x13, 0x6, 0x7, 0x2a, 0x86, 0x48, 0xce, 0x3d, 0x2, 0x1, 0x6, 0x8,
    0x2a, 0x86, 0x48, 0xce, 0x3d, 0x3, 0x1, 0x7, 0x3, 0x42, 0x0, 0x4, 0x1d, 0x41, 0xb0, 0x52,
    0x6d, 0x91, 0xe6, 0xea, 0x1a, 0xe4, 0x22, 0x81, 0x23, 0x34, 0x8d, 0x8e, 0x7f, 0x6b, 0xf2, 0x60,
    0x7d, 0x48, 0x85, 0x4b, 0xe4, 0x5c, 0x6, 0x3c, 0x62, 0x24, 0xc7, 0xc8, 0x18, 0xdb, 0x5d, 0xd9,
    0x31, 0x7b, 0x7, 0x75, 0xe5, 0x24, 0x9c, 0xc8, 0xc6, 0xd5, 0x80, 0x89, 0x69, 0x20, 0x93, 0xbb,
    0x1a, 0xc1, 0xbd, 0xd, 0x29, 0x3, 0x46, 0x4e, 0xcb, 0xf9, 0xe8, 0x9d, 0xa3, 0x59, 0x30, 0x57,
    0x30, 0xb, 0x6, 0x3, 0x55, 0x1d, 0xf, 0x4, 0x4, 0x3, 0x2, 0x7, 0x80, 0x30, 0x14, 0x6,
    0x3, 0x55, 0x1d, 0x11, 0x4, 0xd, 0x30, 0xb, 0x82, 0x9, 0x6c, 0x6f, 0x63, 0x61, 0x6c, 0x68,
    0x6f, 0x73, 0x74, 0x30, 0x13, 0x6, 0x3, 0x55, 0x1d, 0x25, 0x4, 0xc, 0x30, 0xa, 0x6, 0x8,
    0x2b, 0x6, 0x1, 0x5, 0x5, 0x7, 0x3, 0x3, 0x30, 0x1d, 0x6, 0x3, 0x55, 0x1d, 0xe, 0x4,
    0x16, 0x4, 0x14, 0xf2, 0xa5, 0x16, 0x89, 0xa6, 0x64, 0xce, 0x2d, 0xb4, 0x3b, 0xc1, 0xdc, 0xa3,
    0x5b, 0xb3, 0xb9, 0x72, 0x51, 0x10, 0xf5, 0x30, 0xa, 0x6, 0x8, 0x2a, 0x86, 0x48, 0xce, 0x3d,
    0x4, 0x3, 0x2, 0x3, 0x48, 0x0, 0x30, 0x45, 0x2, 0x20, 0x4d, 0xe5, 0x5a, 0x1c, 0x6d, 0x63,
    0xbe, 0xad, 0x1e, 0xb, 0x5c, 0x7, 0x5f, 0xce, 0x15, 0xd0, 0x9, 0xcd, 0x12, 0xbe, 0x31, 0xbf,
    0x43, 0x10, 0x91, 0xeb, 0x9c, 0x3f, 0x91, 0x3f, 0x45, 0xc1, 0x2, 0x21, 0x0, 0x8c, 0xe6, 0x77,
    0x4c, 0x52, 0x4, 0xa, 0x5d, 0xbd, 0x98, 0xee, 0xca, 0xa4, 0xe9, 0x36, 0x6b, 0x42, 0x27, 0xa3,
    0x62, 0x8c, 0x13, 0x6b, 0x3f, 0xec, 0x42, 0x82, 0xfb, 0x33, 0xfe, 0xfd, 0x8b
};
const uint16_t arm_uc_default_certificate_size = sizeof(arm_uc_default_certificate);
#endif


#ifdef MBED_CLOUD_DEV_UPDATE_PSK
const uint8_t arm_uc_default_psk[] = {
    
};
const uint8_t arm_uc_default_psk_size = sizeof(arm_uc_default_psk);
const uint16_t arm_uc_default_psk_bits = sizeof(arm_uc_default_psk)*8;

const uint8_t arm_uc_default_psk_id[] = {
    
};
const uint8_t arm_uc_default_psk_id_size = sizeof(arm_uc_default_psk_id);
#endif
