PelionIoT/reference-design-RD1622/(commit log)

2018-09-20 Initial version
    [DAPlink-LPC11U35-v1.1.0.sch, MCB-Wise-1530-v2.0.1-BOM.csv, MCB-Wise-1530-v2.0.1-BOM.xlsx, MCB-Wise-1530-v2.0.1.brd, MCB-Wise-1530-v2.0.1.sch, MTB-v2.0.0-BOM.csv, MTB-v2.0.0-BOM.xlsx, MTB-v2.0.0.brd]
2018-09-20 New Ref sch
    [Advantech-Wise-1530-v1.0.0.sch]
2018-09-25 BOM's updated
    [MCB-Wise-1530-v2.0.1-BOM.csv, MTB-v2.0.0-BOM.csv]
